AdlerFarHorizons/FHComm/README.md

This should contain a complete but brief description of the project and its purpose.

It should also include entries for major version numbers which include the date and highlights of what's changed or improved.
