AdlerFarHorizons/FHComm/hardware/pcb/CommPosition_V1.0_BottomStencil.pdf

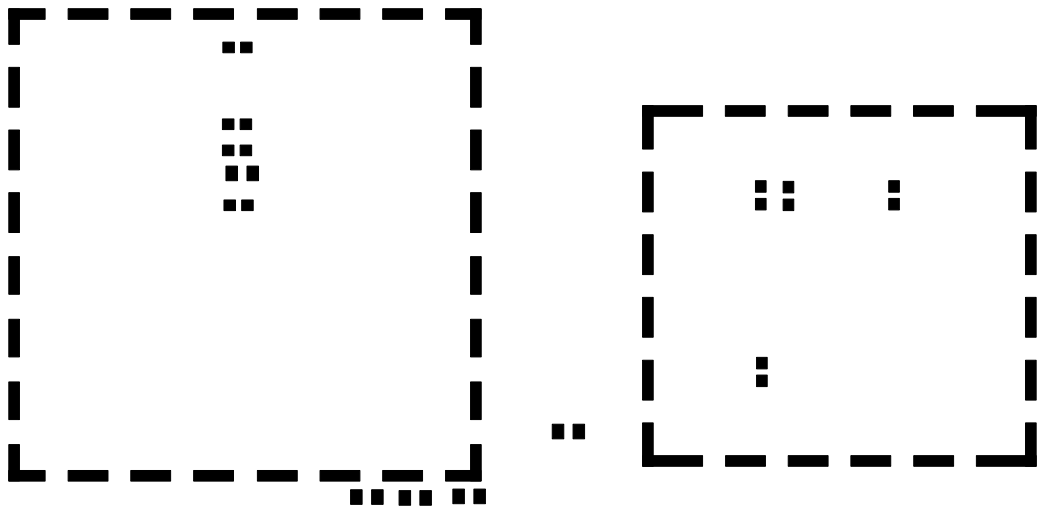
[picture p1: page 1]
