AdlerFarHorizons/FHComm/hardware/pcb/CommPosition_V1.0_TopStencil.pdf

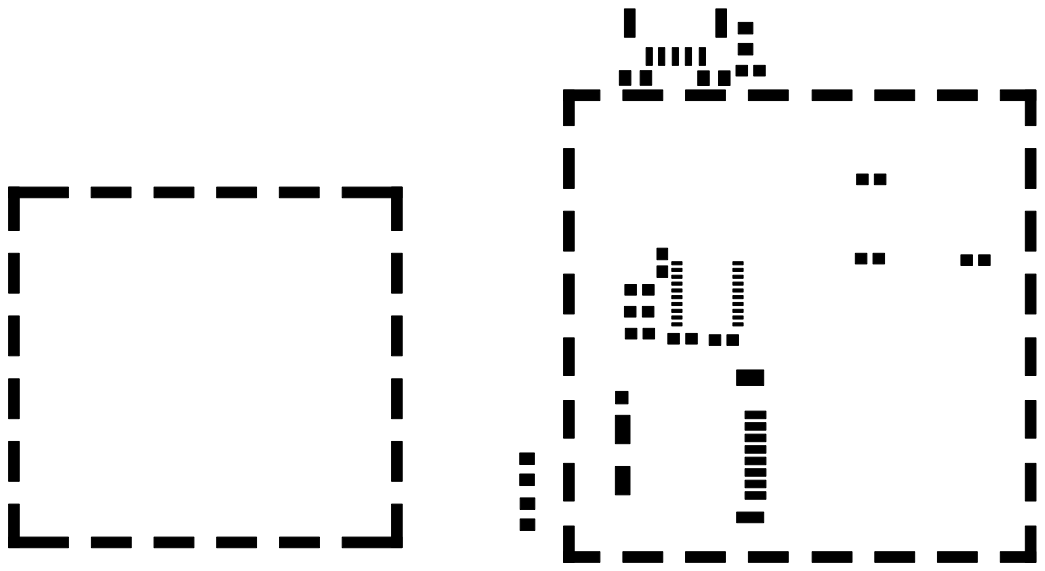
[picture p2: page 1]
