AdlerFarHorizons/FHComm/hardware/pcb/CommPosition_V1.0_Mar2016.brd

## EAGLE design hardware/pcb/CommPosition_V1.0_Mar2016.brd (2016-10-24)

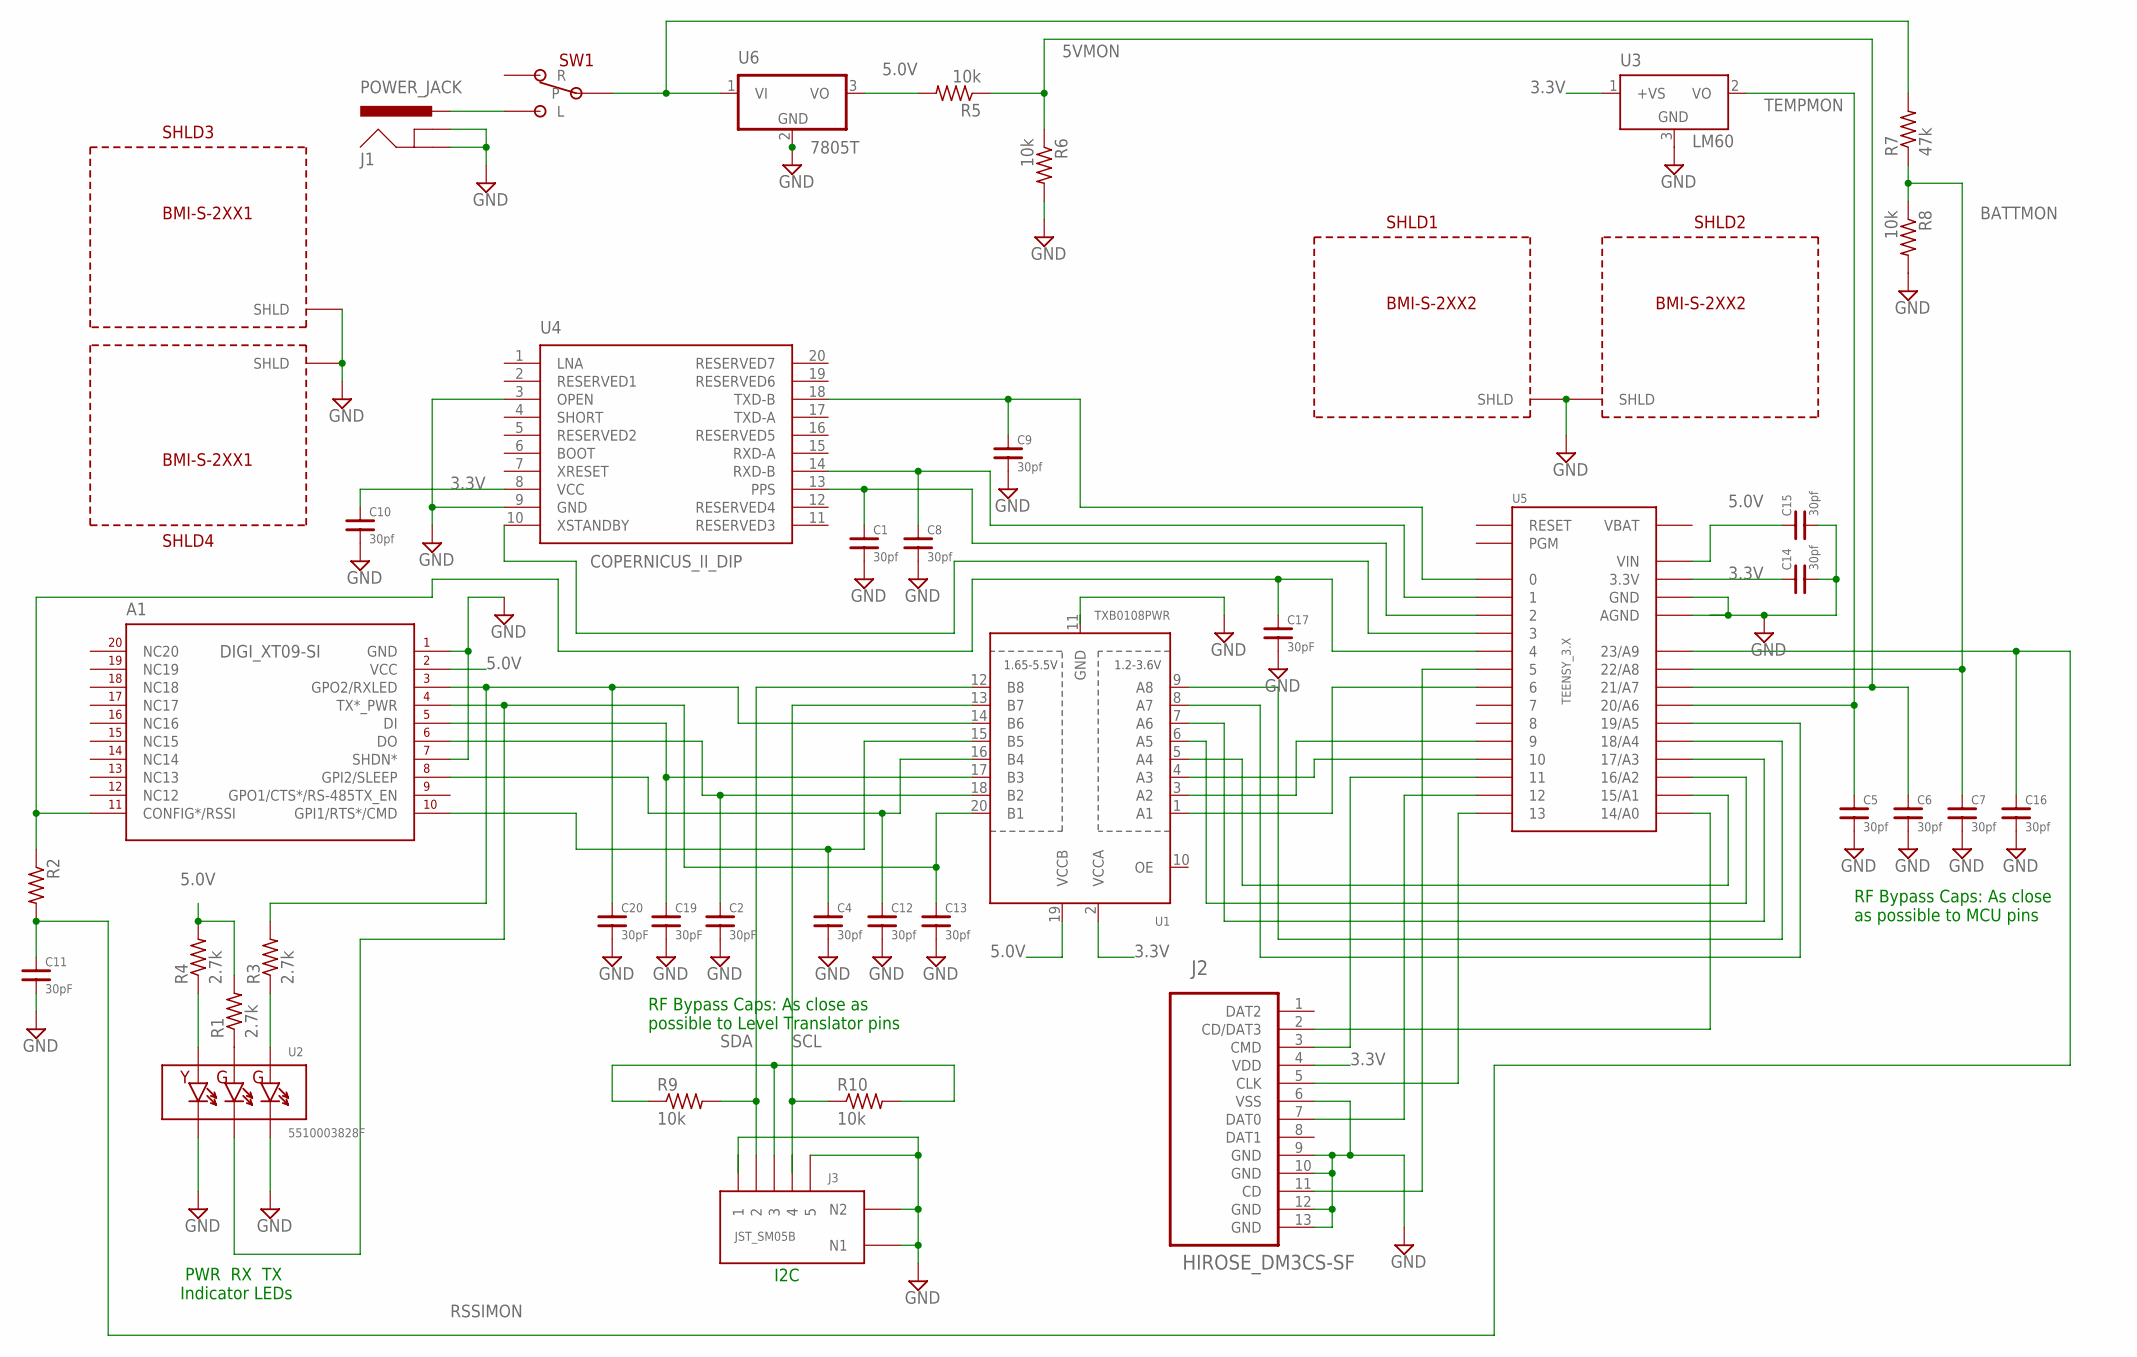
[picture p3: schematic CommPosition_V1.0_Mar2016.sch]

Parts:
A1: DIGI_XT09-SI
C1, C4, C5, C6, C7, C8, C9, C10, C12, C13, C14, C15, C16: 30pf; C0603
C2, C11, C17, C19, C20: 30pF; C0603
J1: POWER_JACK; PWR_JACK_BB
J2: HIROSE_DM3CS-SF
J3: JST_SM05B
R1, R3, R4: 2.7k; R0805
R2: R-US_R0805; R0805
R5, R6, R8, R9, R10: 10k; R0805
R7: 47k; R0805
SHLD1, SHLD2: BMI-S-2XX2; BMI-S-207-F
SHLD3, SHLD4: BMI-S-2XX1; BMI-S-206-F
SW1: SPDT_RA_3A; ESWITCH_SPDT_RA
U1: TXB0108PWR; TSSOP20
U2: 5510003828F; TRIPLE_LED_SIDE_0.1IN
U3: LM60; TO92
U4: COPERNICUS_II_DIP
U5: TEENSY_3.X; TEENSY_3.X_PERIPHERY
U6: 7805T; TO220H

Connections:
3.3V: C10.1, C14.1, J2.4 (VDD), U1.2 (VCCA), U3.1 (+VS), U4.8 (VCC), U5.3.3V, U5.3.3V1 (3.3V)
5.0V: A1.P$2 (VCC), C15.1, R1.2, R4.2, R5.2, U1.19 (VCCB), U5.VIN, U6.3 (VO)
5VMON: C6.1, R5.1, R6.1, U5.21/A7
BATTMON: C7.1, R7.1, R8.1, U5.22/A8
GND: A1.P$1 (GND), A1.P$7 (SHDN*), A1.P$21 (GND), A1.P$22 (GND), A1.P$23 (GND), A1.P$24 (GND), C1.2, C2.2, C4.2, C5.2, C6.2, C7.2, C8.2, C9.2, C10.2, C11.2, C12.2, C13.2, C14.2, C15.2, C16.2, C17.2, C19.2, C20.2, J1.GND, J1.GNDBREAK, J2.6 (VSS), J2.9 (GND), J2.10 (GND), J2.12 (GND), J2.13 (GND), J3.P$1 (1), J3.P$5 (5), J3.P$6 (N1), J3.P$7 (N2), R6.2, R8.2, SHLD1.P$2, SHLD1.P$3, SHLD1.P$4, SHLD1.P$5, SHLD1.P$6, SHLD1.P$7, SHLD1.P$8, SHLD1.P$9, SHLD1.P$10, SHLD1.P$11, SHLD1.P$12, SHLD1.P$14, SHLD1.P$15, SHLD1.P$16, SHLD1.P$17, SHLD1.P$18, SHLD1.P$19, SHLD1.P$20, SHLD1.P$21, SHLD1.P$22, SHLD1.P$23, SHLD1.P$24, SHLD1.P$25, SHLD1.P$26, SHLD1.P$27, SHLD1.P$28, SHLD1.P$29, SHLD1.P$30, SHLD1.P$31, SHLD1.P$32, SHLD1.P$33, SHLD1.P$34, SHLD2.P$2, SHLD2.P$3, SHLD2.P$4, SHLD2.P$5, SHLD2.P$6, SHLD2.P$7, SHLD2.P$8, SHLD2.P$9, SHLD2.P$10, SHLD2.P$11, SHLD2.P$12, SHLD2.P$14, SHLD2.P$15, SHLD2.P$16, SHLD2.P$17, SHLD2.P$18, SHLD2.P$19, SHLD2.P$20, SHLD2.P$21, SHLD2.P$22, SHLD2.P$23, SHLD2.P$24, SHLD2.P$25, SHLD2.P$26, SHLD2.P$27, SHLD2.P$28, SHLD2.P$29, SHLD2.P$30, SHLD2.P$31, SHLD2.P$32, SHLD2.P$33, SHLD2.P$34, SHLD3.P$1, SHLD3.P$2, SHLD3.P$3, SHLD3.P$4, SHLD3.P$5, SHLD3.P$6, SHLD3.P$7, SHLD3.P$8, SHLD3.P$9, SHLD3.P$10, SHLD3.P$11, SHLD3.P$12, SHLD3.P$14, SHLD3.P$15, SHLD3.P$16, SHLD3.P$17, SHLD3.P$18, SHLD3.P$21, SHLD3.P$22, SHLD3.P$23, SHLD3.P$24, SHLD3.P$25, SHLD3.P$31, SHLD3.P$32, SHLD4.P$1, SHLD4.P$2, SHLD4.P$3, SHLD4.P$4, SHLD4.P$5, SHLD4.P$6, SHLD4.P$7, SHLD4.P$8, SHLD4.P$9, SHLD4.P$10, SHLD4.P$11, SHLD4.P$12, SHLD4.P$14, SHLD4.P$15, SHLD4.P$16, SHLD4.P$17, SHLD4.P$18, SHLD4.P$21, SHLD4.P$22, SHLD4.P$23, SHLD4.P$24, SHLD4.P$25, SHLD4.P$31, SHLD4.P$32, U1.11 (GND), U2.P$1 (1), U2.P$5 (5), U3.3 (GND), U4.3 (OPEN), U4.9 (GND), U5.AGND, U5.GND, U5.GND1 (GND), U6.2 (GND)
unnamed: J2.7 (DAT0), U5.12
unnamed: J2.3 (CMD), U5.11
unnamed: J2.5 (CLK), U5.13
unnamed: U1.3 (A2), U5.9
unnamed: A1.P$5 (DI), C19.1, U1.17 (B3)
unnamed: U1.9 (A8), U5.18/A4
unnamed: J2.2 (CD/DAT3), U5.14/A0
unnamed: A1.P$6 (DO), C2.1, U1.18 (B2)
unnamed: U1.8 (A7), U5.19/A5
unnamed: A1.P$10 (GPI1/RTS*/CMD), C4.1, U1.15 (B5)
unnamed: A1.P$4 (TX*_PWR), C13.1, U1.20 (B1), U2.P$3 (3)
unnamed: A1.P$8 (GPI2/SLEEP), C12.1, U1.16 (B4)
unnamed: A1.P$3 (GPO2/RXLED), C20.1, R3.2, U1.14 (B6)
unnamed: U1.1 (A1), U5.6
unnamed: A1.P$11 (CONFIG*/RSSI), C17.1, R2.1, U5.4
unnamed: R7.2, SW1.P$2, U6.1 (VI)
unnamed: J1.PWR, SW1.P$1 (L)
unnamed: J2.11 (CD), U5.5
unnamed: U4.10 (XSTANDBY), U5.3
unnamed: J3.P$3 (3), R9.1, R10.2
unnamed: U1.5 (A4), U5.15/A1
unnamed: U1.6 (A5), U5.16/A2
unnamed: U1.4 (A3), U5.10
unnamed: U1.7 (A6), U5.17/A3
unnamed: C9.1, U4.18 (TXD-B), U5.0
unnamed: C8.1, U4.14 (RXD-B), U5.1
unnamed: C1.1, U4.13 (PPS), U5.2
unnamed: R1.1, U2.P$4 (4)
unnamed: R3.1, U2.P$2 (2)
unnamed: R4.1, U2.P$6 (6)
RSSIMON: C11.1, C16.1, R2.2, U5.23/A9
SCL: J3.P$4 (4), R10.1, U1.13 (B7)
SDA: J3.P$2 (2), R9.2, U1.12 (B8)
TEMPMON: C5.1, U3.2 (VO), U5.20/A6

Notes on the sheet:
RF Bypass Caps: As close as possible to MCU pins
PWR RX TX Indicator LEDs
RF Bypass Caps: As close as possible to Level Translator pins
I2C

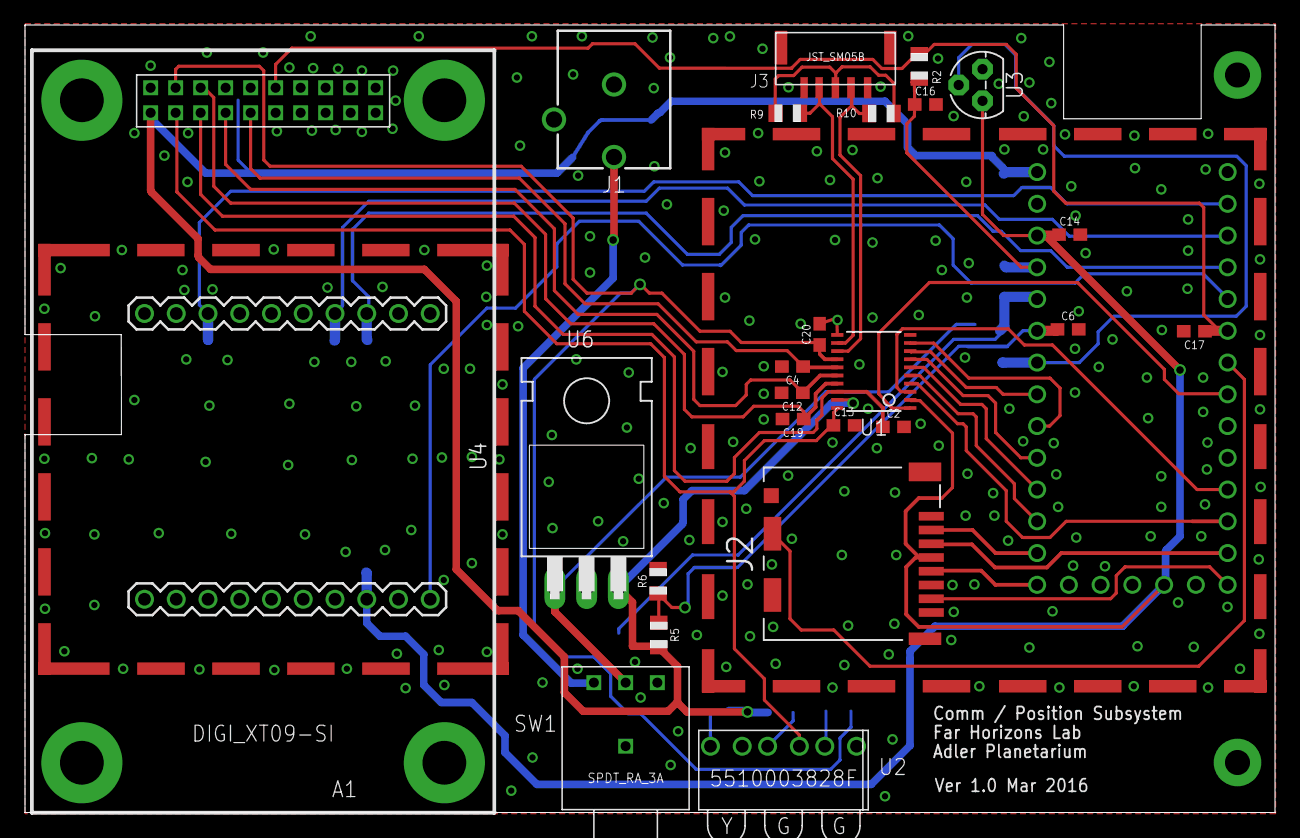
[picture p4: board CommPosition_V1.0_Mar2016.brd from above]

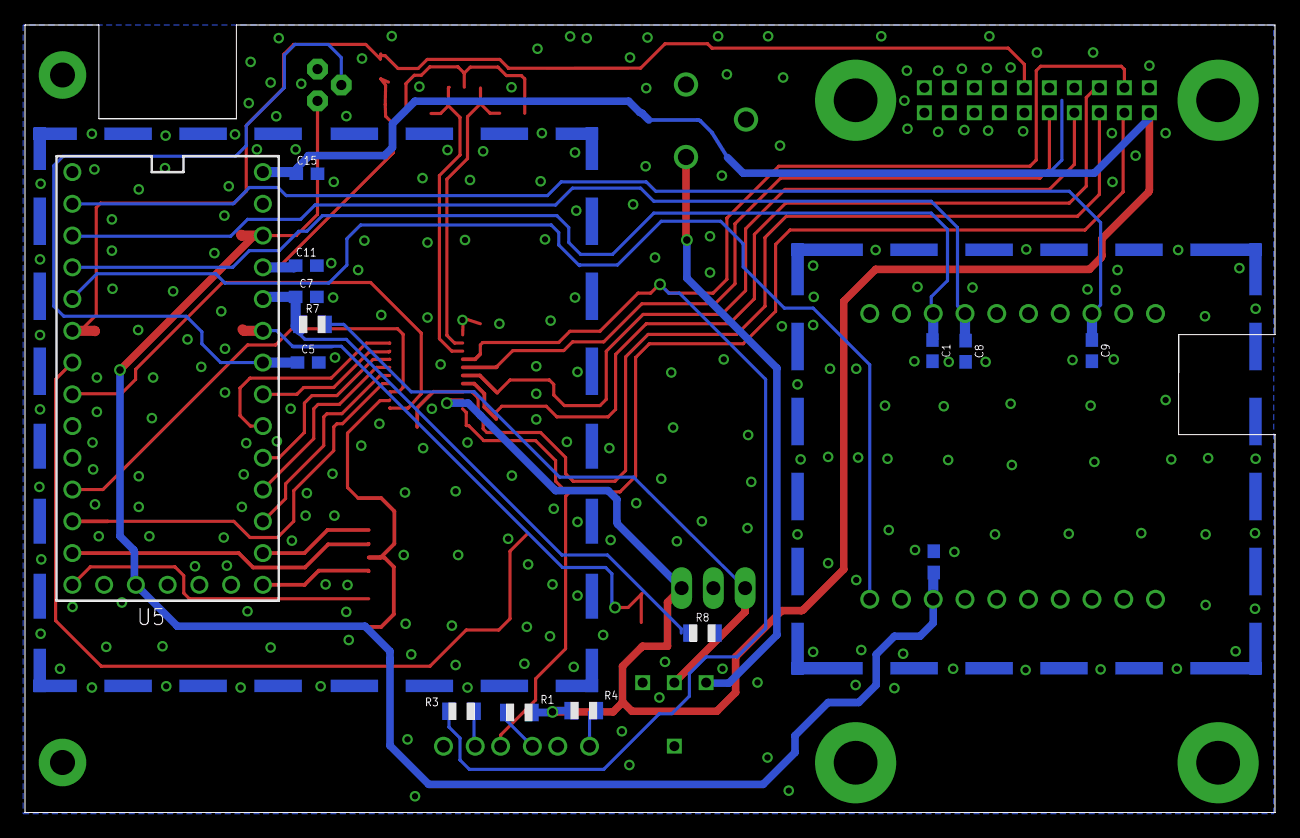
[picture p5: board CommPosition_V1.0_Mar2016.brd from below]

Board: 2 copper layers, 100.0 x 63.0 mm, 43 parts (16 on the bottom side), 39 nets.
