AdlerFarHorizons/FHComm/(commit log)

2016-10-24 Initial commit from XTendGroundTeensy and XTendPayloadTeensy code in Transceiver project.
    [CommPosition_V1.0_Mar2016.brd, CommPosition_V1.0_Mar2016.sch, XtendTeensy.brd, XtendTeensy.sch]
2017-01-06 Re-arrange and simplify round-robin loop; Update flowchart (still incomplete). Flag checking order in loop had included sequential tasks.
2017-07-23 Fix output power for field use
    [CommPositionGround.ino]
2017-11-22 Basic Command infrastructure; crude single uplink command with relay to OBC and response back down to ground.
2018-01-21 Housekeeping; Eliminate redundant checksum; Prevent RX array overrun.
    [CommPositionGround.ino, CommPositionPayload.ino]
2018-01-21 Add payload background spectrum measure; Extend payload transceiver wake time for ground response; Add payload spectrum display to ground monitor.
2018-03-31 Fix command mode lockup if CR is entered alone; Echo mode modifications.
    [Maint.h]
